mhorimoto/M800-NCxPoE/001-001.jpg

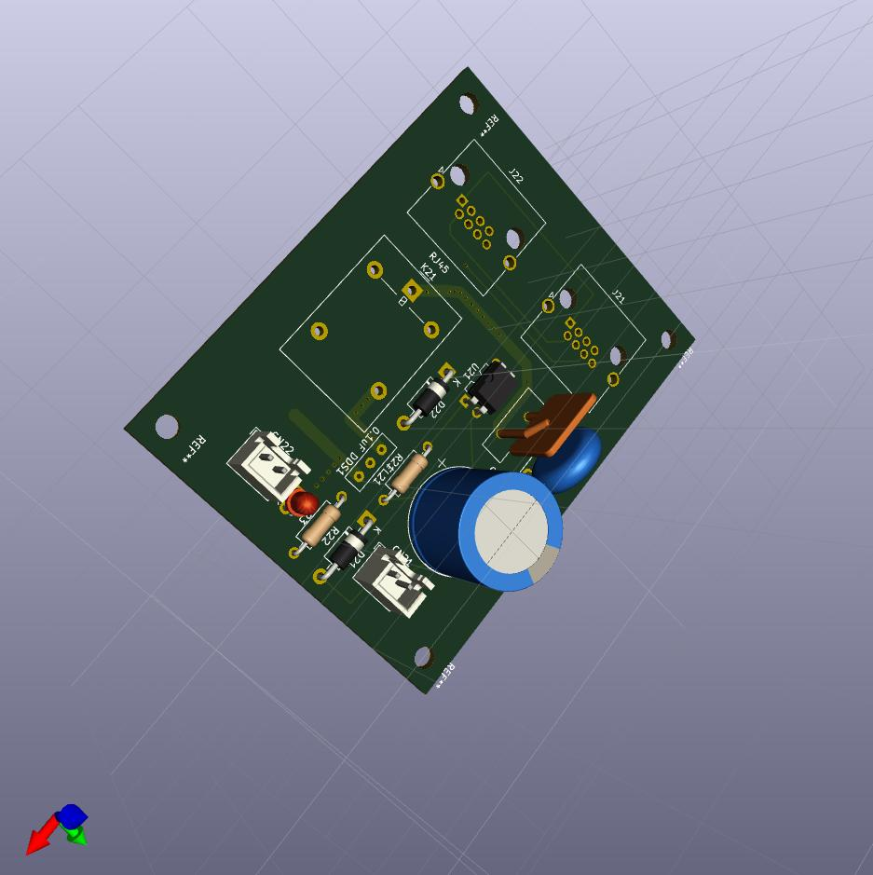
001-001.jpg
