mhorimoto/M800-NCxPoE/001.kicad_pcb

## KiCad design 001.kicad_pcb (2024-12-23)

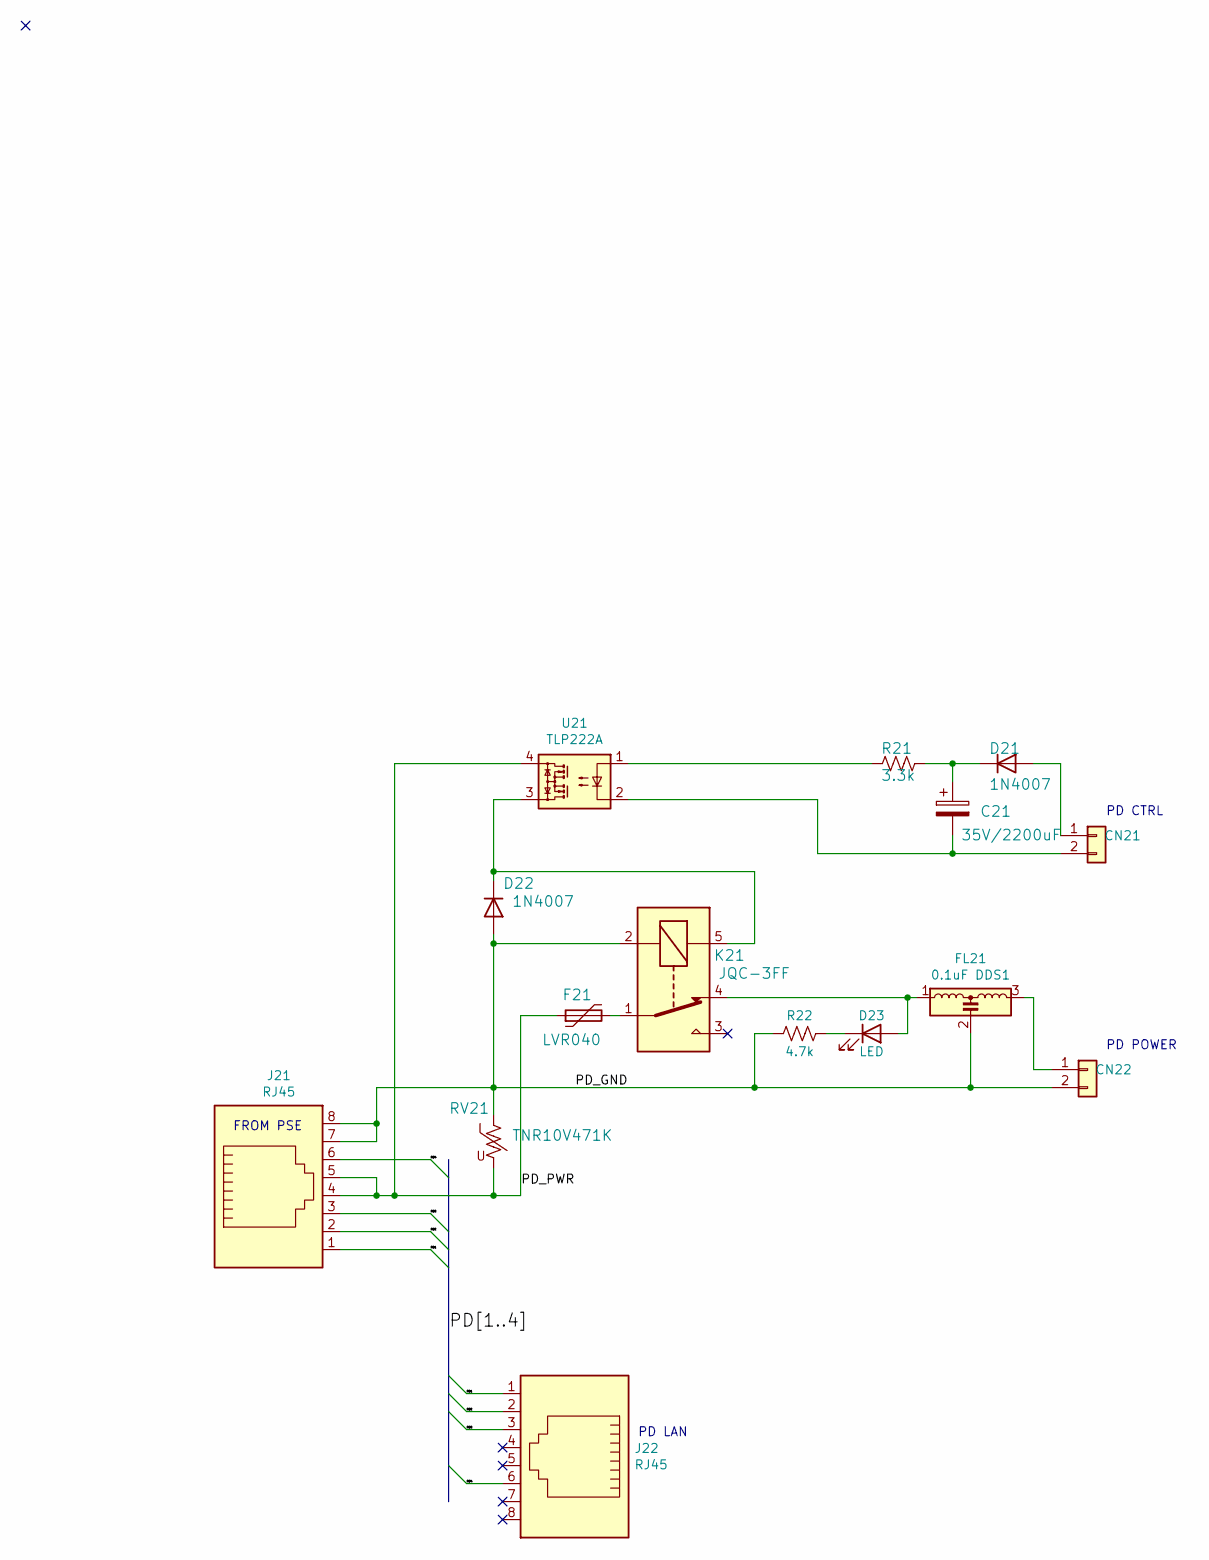
[picture p2: schematic 001.kicad_sch, M800-NCxPoE-PD]

Parts:
C21: 35V/2200uF; CP_Radial_D16.0mm_P7.50mm
CN21, CN22: 02-XH-A; JST_XH_B2B-XH-A_1x02_P2.50mm_Vertical
D21, D22: 1N4007; D_DO-41_SOD81_P10.16mm_Horizontal
D23: LED; LED_D3.0mm
F21: LVR040; Fuse_BelFuse_0ZRE0033FF_L11.4mm_W3.8mm
FL21: 0.1uF DDS1; DSS1
J21, J22: RJ45; RJ45_Neltron_7810-8P8C
K21: JQC-3FF; Relay_SPDT_Omron-G5LE-1
R21: 3.3k; R_Axial_DIN0207_L6.3mm_D2.5mm_P10.16mm_Horizontal
R22: 4.7k; R_Axial_DIN0207_L6.3mm_D2.5mm_P10.16mm_Horizontal
RV21: TNR10V471K; RV_Disc_D12mm_W3.9mm_P7.5mm
U21: TLP222A; DIP-4_W7.62mm

Connections:
/PD1: J21.1, J22.1
/PD2: J21.2, J22.2
/PD3: J21.3, J22.3
/PD4: J21.6, J22.6
/PD_GND: CN22.2, D22.2 (A), FL21.2, J21.7, J21.8, K21.2, R22.2, RV21.1
/PD_PWR: F21.1, J21.4, J21.5, RV21.2, U21.4
unnamed: C21.1, D21.1 (K), R21.1
unnamed: C21.2, CN21.2, U21.2
unnamed: CN21.1, D21.2 (A)
unnamed: CN22.1, FL21.3
unnamed: D22.1 (K), K21.5, U21.3
unnamed: D23.1 (K), R22.1
unnamed: D23.2 (A), FL21.1, K21.4
unnamed: F21.2, K21.1
unnamed: R21.2, U21.1

Notes on the sheet:
PD LAN
FROM PSE
PD CTRL
PD POWER

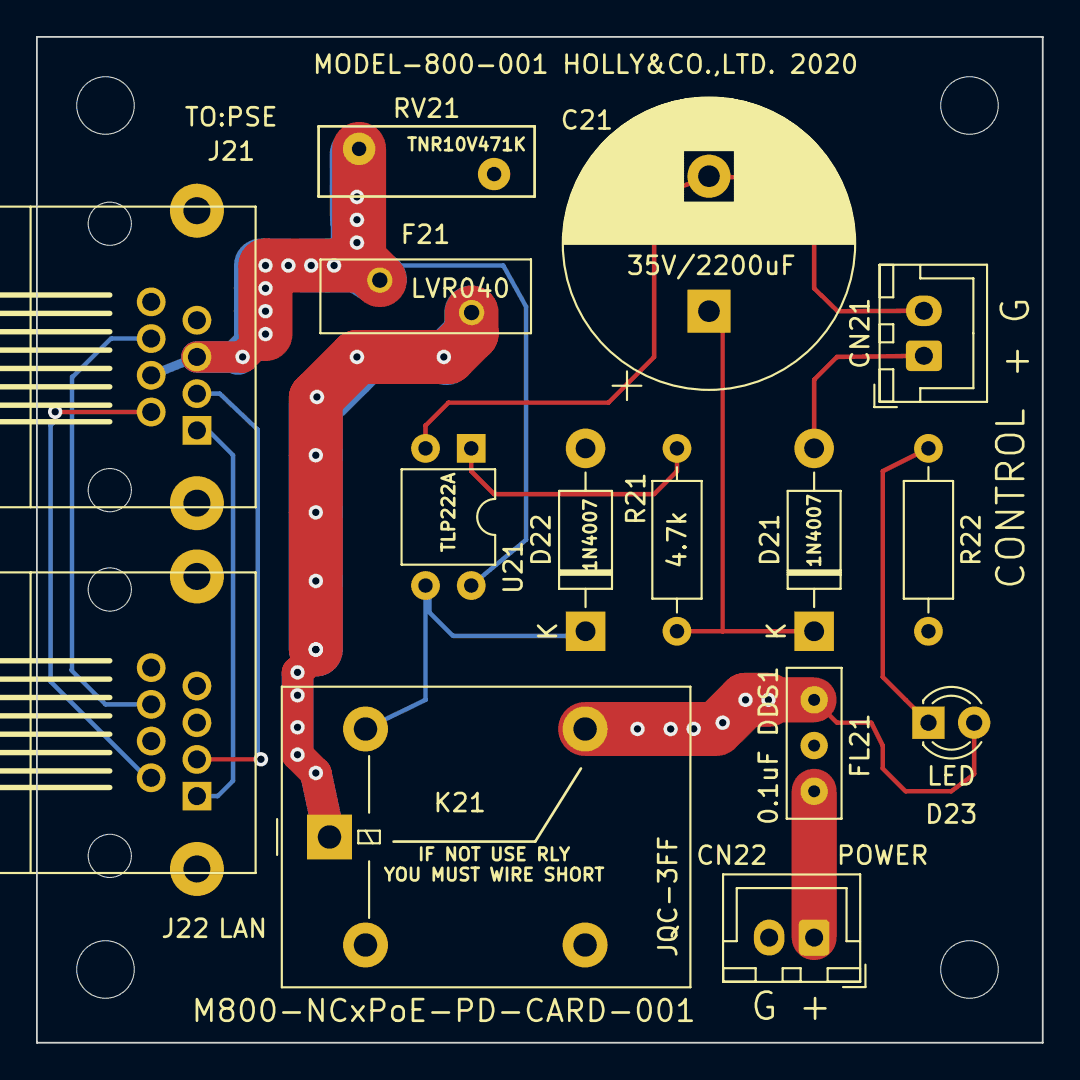
[picture p3: board 001.kicad_pcb from above]

Board: 2 copper layers, 55.9 x 55.9 mm, 15 parts (0 on the bottom side), 15 nets.
