mhorimoto/M800-NCxPoE/(commit log)

2020-06-22 リレーコイル電源を5V化する必要が有る場合にはレギュレータを入れる
    [001.brd, 001.sch]
2020-06-23 実機試験用
2020-06-28 これからPCB
    [001.brd, 001.kicad_pcb]
2020-06-30 PSE側art work
    [001.sch]
2020-07-01 PCB変更とRJ45コネクタのFP作り
    [001.kicad_pcb]
2020-07-02 もうちょっとRJ45コネクタは大変更
    [001.kicad_pcb, 001.sch]
2020-07-03 RJ45 SOCKETを組み直し
    [001.kicad_pcb]
2020-07-06 更に小型化
    [001.kicad_pcb]
2020-07-18 一応完成、これからガーバー
    [001.kicad_pcb, 001.sch]
2020-07-24 PSEとPDを別図面にした
    [001.kicad_pcb, 001.sch]
2020-08-05 テストプログラム追加
2024-02-10 version合わせ
    [001.kicad_pcb, 001.kicad_sch, 001.sch, 002.kicad_sch, 002.sch]
2024-12-23 KiCAD Version
    [001-B_Cu.gbr, 001-B_Mask.gbr, 001-B_SilkS.gbr, 001-Edge_Cuts.gbr, 001-F_Cu.gbr, 001-F_Mask.gbr, 001-F_SilkS.gbr, 001-NPTH.drl]
